Alejuarez10sk8/Router_CNC_12x_21y_21z/conexion_arduino_mega.png

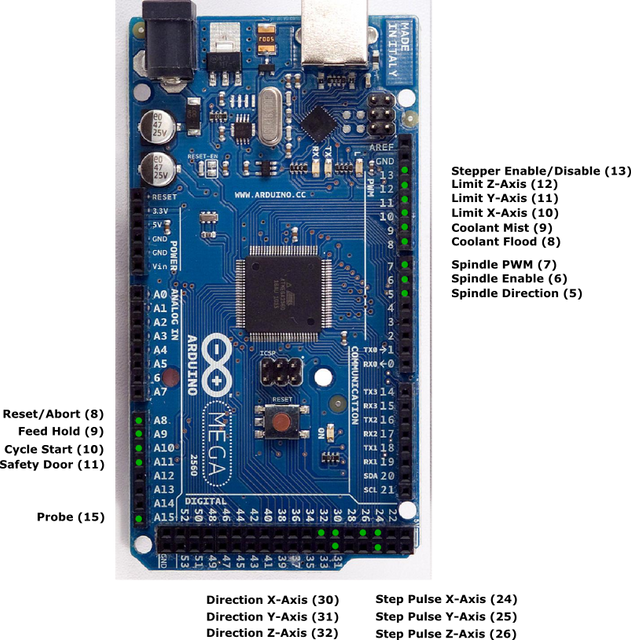
conexion_arduino_mega.png
