Alejuarez10sk8/Router_CNC_12x_21y_21z/README.md

# Router_CNC_12x_21y_21z
Primer_router_cnc
