Alejuarez10sk8/Router_CNC_12x_21y_21z/00_Componentes_presupuestos/COMPONENTES.xlsx

Nombre | Cantidad | Precio unitario ($) | Precio total ($) | Precio dólar | Fecha adquirida | Caracteristicas | Link
Motor Paso A Paso Nema 17 | 1 | 2834 | 2834 | 17.56 | 2021-09-27 | 42CM08-1A_0.8Nm | https://articulo.mercadolibre.com.ar/MLA-785472520-motor-paso-a-paso-nema-23-alto-torque-23-nm-2345-kgcm-_JM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
Motor Paso A Paso Nema 23 | 3 | 5057 | 15171 | 94.00 | 2021-09-27 | 57CM23-4A_24Vcc hasta 100Vcc_18Vca hasta 80Vca_2.3Nm | https://articulo.mercadolibre.com.ar/MLA-869936039-motor-paso-a-paso-nema-17-alto-torque-80-ncm-815-kgcm-_JM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
Perfil Aluminio Guía Lineal - 1 Metro | 4 | 1759 | 7036 | 43.59 | 2021-10-05 |  | https://articulo.mercadolibre.com.ar/MLA-856232254-perfil-aluminio-guia-lineal-1-metro-impresora-3d-cnc-_JM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
Rosca Cuadrada Acme De 5/8 X 1 Metro Con 2 Tuercas Redondas | 3 | 2800 | 8400 | 52.04 | 2021-10-05 |  | https://articulo.mercadolibre.com.ar/MLA-1103574786-rosca-cuadrada-acme-de-58-x-1-metro-con-2-tuercas-redondas-_JM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
Acero Sae 1045, Redondo Trefilado 16mm X 4 Mtrs - Cripton | 1 | 2768 | 3908 | 24.21 | 2021-10-05 | 16mm X 4 Mtrs los divido en 4 | https://articulo.mercadolibre.com.ar/MLA-852005307-acero-sae-1045-redondo-trefilado-16mm-x-4-mtrs-cripton-_JM
Fresadora Lüsqtoff FRL1400-9 1400W 220V | 1 | 13999 | 13999 | 86.73 | 2021-10-12 | Vel. mín 9000rpm Vel máx de 28000rpm Pesa 5.76kg. | https://www.mercadolibre.com.ar/fresadora-lusqtoff-frl1400-9-1400w-220v/p/MLA16062500
Driver Modular Tb6600 Step Paso A Paso 42v 4a | 4 | 2500 | 10000 | 61.96 | 2021-10-22 | Output current: IOUT = 5.0A (peak within 100ms) Rated output: IOUT = 4.5 A // Voltage: up to 40V | https://articulo.mercadolibre.com.ar/MLA-864924852-driver-modular-tb6600-step-paso-a-paso-42v-4a-arduino-ubot-_JM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
Arduino Mega | 2 | 1400 | 2800 | 16.97 | 2021-11-02 | Quemé uno | particular
Contacflux | 1 | 520 | 520 | 3.15 | 2021-11-09 |  | digital electronica
Bornera 2 Pines Paso 5mm | 10 |  | 287 | 1.74 | 2021-11-09 | 10 en 1 paquete | https://articulo.mercadolibre.com.ar/MLA-868322083-10-unidades-bornera-2-pines-paso-5mm-electronica-proyectos-_JM
Bornera 3 Pines Paso 5mm | 10 |  | 364 | 2.21 | 2021-11-09 | 10 en 1 paquete | https://articulo.mercadolibre.com.ar/MLA-868322046-10-unidades-bornera-3-pines-paso-5mm-electronica-proyectos-_JM
Plaqueta virgen 10*5cm pertinax | 1 | 90 | 90 | 0.55 | 2021-11-09 |  | digital electronica
Carro Rodamiento Lineal Abierto Sbr16 Sbr16uu // Ø 16mm | 8 | 1432.52 | 11460 | 69.45 | 2021-11-09 |  | https://articulo.mercadolibre.com.ar/MLA-607166347-carro-rodamiento-lineal-abierto-sbr16-sbr16uu-16mm-_JM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
Rodamiento Lineal Cerrado Scs12uu // Ø 12mm | 4 | 953.3 | 3813 | 23.11 | 2021-11-09 |  | https://articulo.mercadolibre.com.ar/MLA-809228968-rodamiento-lineal-cerrado-scs12uu-12mm-_JM?quantity=4
Barra Eje Lineal 12mm Hrc60 Templada Rectificada Cromada | 1 | 2101 | 2101 | 12.73 | 2021-11-09 | 500mm cortada en dos (250mm=25cm cada una) | https://articulo.mercadolibre.com.ar/MLA-761514484-barra-eje-lineal-12mm-hrc60-templada-rectificada-cromada-_JM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
Micro Switch Final De Carrera | 4 | 100 | 400 | 2.42 | 2021-11-09 | 5A 250v Cnc Arduino Leva Corta | particular
Fuente Switching Biqu (24v / 360w / 15A ) | 2 | 5605 | 12010 | 71.49 | 2021-12-03 | 215x114x50mm (Biqu-B1 / Ender-3) | https://proyectocolor.com.ar/productos/fuente-switching-biqu-24v-360w-15a-215x114x50mm-biqu-b1-ender-3/
Caño rectangular 20x40x2MM 1mt | 8 | 587.5 | 4700 | 27.98 | 2021-12-13 | 1mt | gudiño
Angulo 38.1 x 3.2mm 6.60mts | 1 | 3000 | 3000 | 17.86 | 2021-12-13 | 4 x 70 - 2 x 90 - 2 x 100 | gudiño
Cable mallado 4x1mm 8mts | 1 | 2694 | 2200 | 13.10 | 2021-12-13 | 8mts/ descuento | electrosur
Ruleman skf 99502H | 2 | 300 | 600 | 3.57 | 2021-12-13 | 5/8 interior | parussa rodamientos
Planchuela eje y | 2 | 1600 | 3200 | 19.05 | 2021-12-28 | 4.5kg (2.25 c/u) | gudiño
Planchuela de agarre | 4 | 650 | 2600 | 15.48 | 2021-12-28 | 2.6kg(650g c/u) | gudiño
Angulo 25.4x3.2mm x 0.85mt | 1 | 300 | 300 | 1.79 | 2021-12-28 |  | gudiño
Planchuela 50x3.2mmx 0.25mt | 1 | 150 | 150 | 0.89 | 2021-12-28 | 4x51mm | gudiño
Pintar planchuelas y estructura | 1 | 3800 | 3800 | 21.73 | 2022-01-11 |  | color extremo
Bulones y arandelas | 1 |  | 2000 | 11.44 | 2022-01-25 | bulones 5mm y 5.5mm - tornillos para plaquetas 3mm - tornillos 2mm | Bulonera Centro
Cables para driver y fuente s | 1 |  | 1000 | 5.72 | 2022-02-04 | 2 metros de cable rojo y negro 0.75/1mm2 - 0.5 metros de cable marron y azul 1.5mm2 - 2 metros de cable verde con linea amarrillas 1.5 mm2 | electrosur
Fibro facil | 5 | 120 | 600 | 3.43 | 2022-01-11 | 350x550x2 + 350x150x2 + 550x150x2 mm | Nobs. NO COMPRAR MÁS AHÍ
Cable UTP categoria 6 o superior | 1 | 200 | 200 | 1.14 | 2022-01-18 | 2 metros | Memory
Impresiones 3d | 1 | 1000 | 1000 | 5.72 | 2022-02-14 | Placa para sostener arduino- bulones para travar varillas | particular
Cable de alimentación 220v con descarga a tierra | 1 | 400 | 400 | 2.29 | 2022-02-14 | 1.5mm diametro | digital electronica
Llave Tecla 3 Contacto Con Luz On-off 15a 250v Rojo | 2 | 350 | 700 | 4.00 | 2022-02-14 | Llave Tecla Redonda Interruptora S-luz 220v - rompí uno - Encontré de tres contacto | electrosur
Bisagra Libro 5005 Bronceada 51mm | 2 | 100 | 200 | 1.14 | 2022-02-14 |  | ferreteria
Interruptor palanca bipolar | 1 | 645 | 645 | 3.69 | 2022-03-01 | 15A | electrosur
Ficha machos con tierra | 2 | 215 | 430 | 2.46 | 2022-03-01 | 20A | electrosur
Tapa blanca de luz | 5 | 44 | 220 | 1.26 | 2022-03-01 |  | electrosur
base de luz blanco | 5 | 35 | 175 | 1.00 | 2022-03-01 |  | electrosur
toma bipolar + tierra | 5 | 170 | 850 | 4.86 | 2022-03-01 | 20A | electrosur
cable 3x1 1,5mm2 | 1 | 173 | 346 | 1.98 | 2022-03-01 | 2,5m | electrosur
cable 3x1 2,5mm2 | 1 | 271 | 815 | 4.66 | 2022-03-01 | 3m | electrosur
Planchuela de acero para agarre de eje Z | 1 | 2500 | 2500 | 13.23 | 2022-05-01 |  | Nico Aimar
Plachuela de acero C de eje Z | 1 | 2000 | 2000 | 10.58 | 2022-05-07 |  | Nico Aimar
 |  |  | 129824 | 783.94
