Alejuarez10sk8/Router_CNC_12x_21y_21z/0_Estructura cnc/Router_CNC_12x_21y_21z.SLDASM

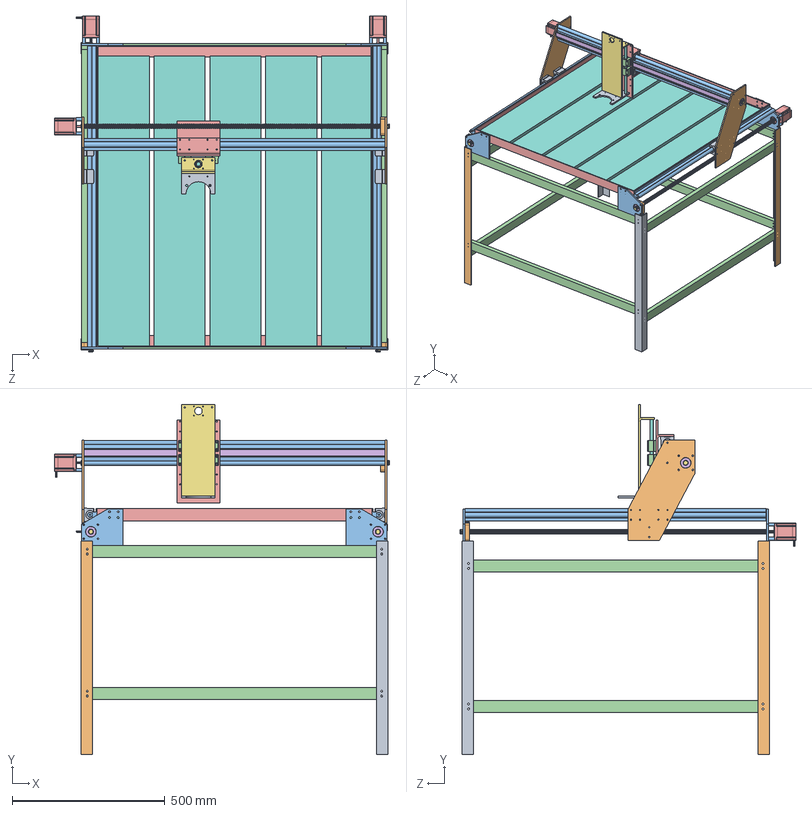
[picture p2: CAD file, 2022-06-06]
0_Estructura cnc/Router_CNC_12x_21y_21z.SLDASM
1096.7 x 1147.3 x 1100.0 mm
Perfil_L_3x38x700 x 2
Simetría_Perfil_L_3x38x700 x 2
Planchuela_eje_X x 4
caño_2x40x20x1000 x 8
estructura_mesa_900x1000
Ruleman16 x 3
rosca_acme_16 x 3
planchas_de_madera
SBR16UU Single Linear Bearing x 8
Planchuela_eje_Y x 2
varilla16_con_soporte_de_aluminio x 4
SCS12UU x 4
planchuela_plegada_en_C_eje_Z
caño_2x40x20x985
planchuela_plegada_parte_de_arriba_Z
varilla_12 x 2
planchuela_parte_de_abajo_Z
apoya_ruleman_int16mm_ext35mm x 3
Separador_motores_20mm x 12
apoya_ruleman_int8mm_ext22mm
NEMA 23.step x 3
