Alejuarez10sk8/Router_CNC_12x_21y_21z/0_Estructura cnc/planchas_de_madera.SLDPRT

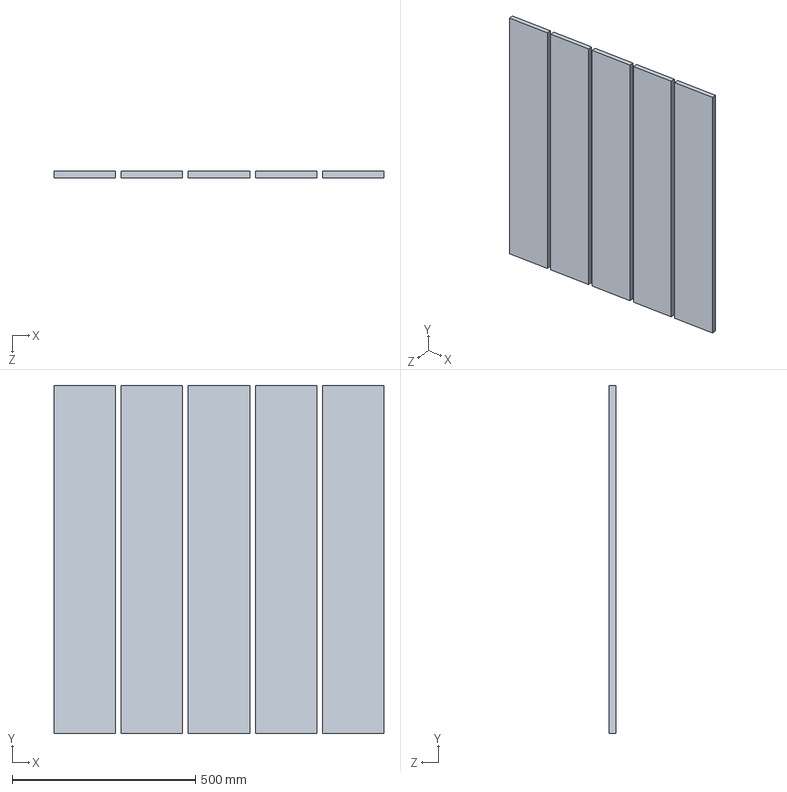
[picture p3: CAD file, 2022-06-06]
0_Estructura cnc/planchas_de_madera.SLDPRT
900.0 x 950.0 x 18.0 mm
