Alejuarez10sk8/Router_CNC_12x_21y_21z/0_Estructura cnc/Ruleman16.SLDPRT

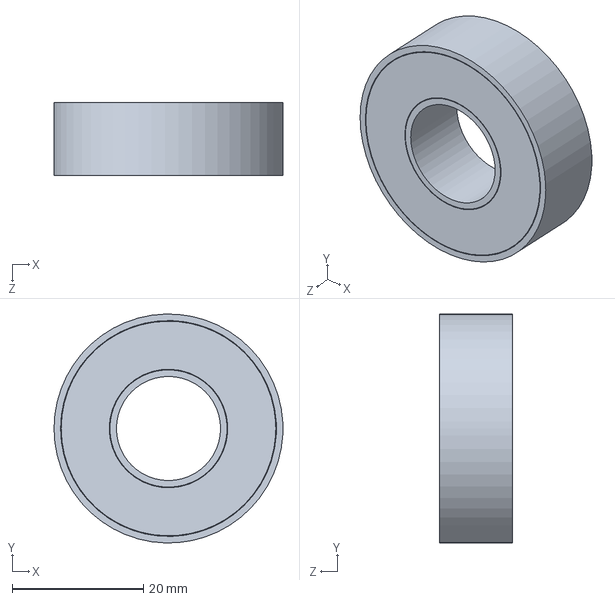
[picture p4: CAD file, 2022-06-06]
0_Estructura cnc/Ruleman16.SLDPRT
34.9 x 34.9 x 11.1 mm
