Alejuarez10sk8/Router_CNC_12x_21y_21z/0_Estructura cnc/apoya_ruleman_int8mm_ext22mm.SLDPRT

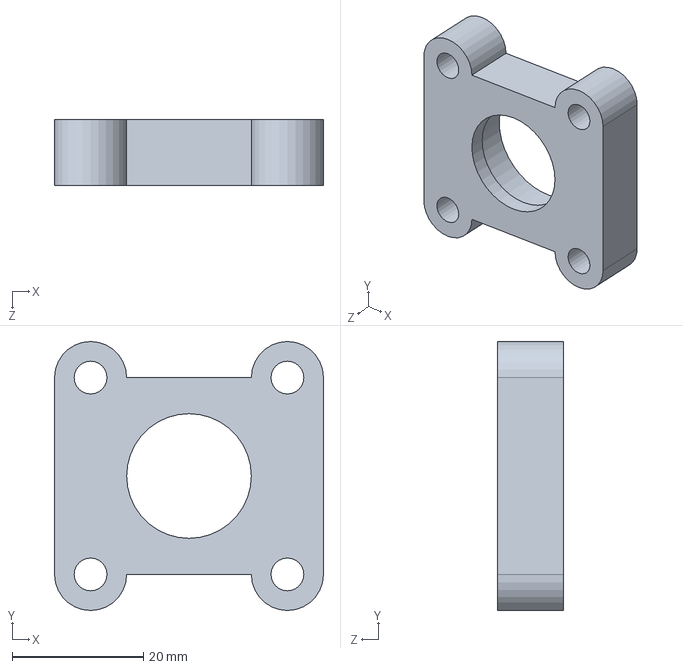
[picture p5: CAD file, 2022-06-06]
0_Estructura cnc/apoya_ruleman_int8mm_ext22mm.SLDPRT
41.0 x 41.0 x 10.0 mm
