Alejuarez10sk8/Router_CNC_12x_21y_21z/0_Estructura cnc/rosca_acme_16.SLDPRT

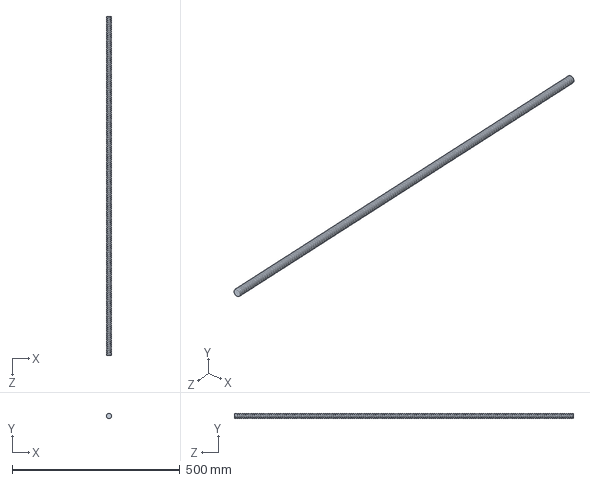
[picture p6: CAD file, 2022-06-06]
0_Estructura cnc/rosca_acme_16.SLDPRT
15.9 x 15.9 x 1010.0 mm
