Alejuarez10sk8/Router_CNC_12x_21y_21z/0_Estructura cnc/NEMA 23.STEP

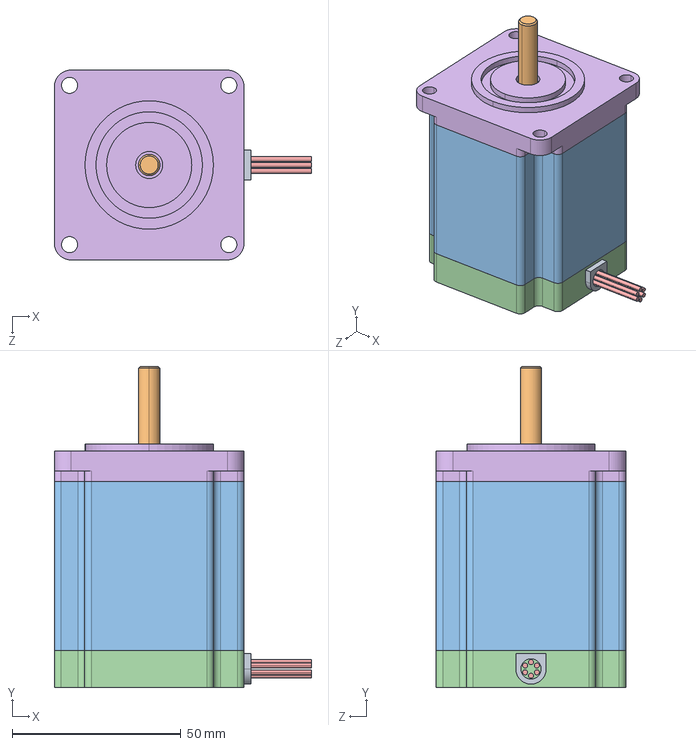
[picture p7: CAD file, 2022-06-06]
0_Estructura cnc/NEMA 23.STEP
76.2 x 95.0 x 56.2 mm
