Alejuarez10sk8/Router_CNC_12x_21y_21z/0_Estructura cnc/planchuela_parte_de_abajo_Z.SLDPRT

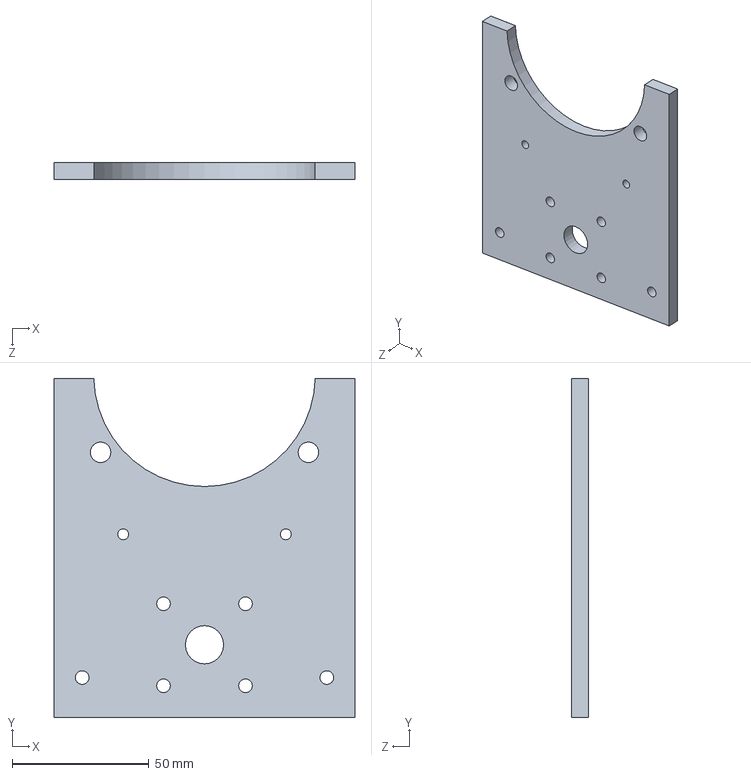
[picture p8: CAD file, 2022-06-06]
0_Estructura cnc/planchuela_parte_de_abajo_Z.SLDPRT
110.0 x 124.0 x 6.35 mm
