Alejuarez10sk8/Router_CNC_12x_21y_21z/0_Estructura cnc/varilla16_con_soporte_de_aluminio.SLDPRT

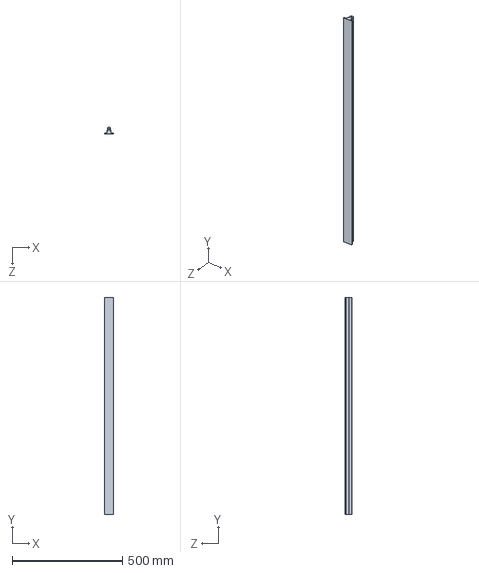
[picture p10: CAD file, 2022-06-06]
0_Estructura cnc/varilla16_con_soporte_de_aluminio.SLDPRT
40.0 x 985.0 x 31.0 mm
