Alejuarez10sk8/Router_CNC_12x_21y_21z/0_Estructura cnc/Separador_motores_10mm.SLDPRT

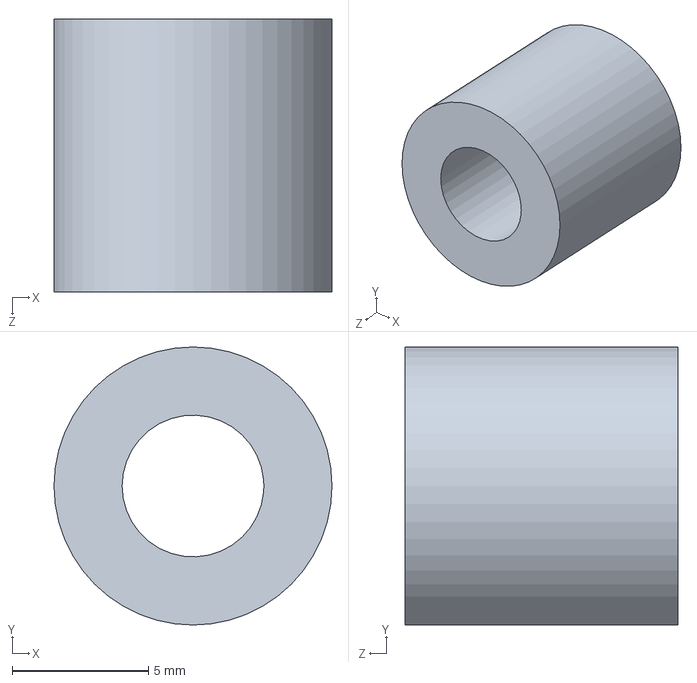
[picture p11: CAD file, 2022-06-06]
0_Estructura cnc/Separador_motores_10mm.SLDPRT
10.2 x 10.2 x 10.0 mm
