Alejuarez10sk8/Router_CNC_12x_21y_21z/0_Estructura cnc/Perfil_L_3x38x700.SLDPRT

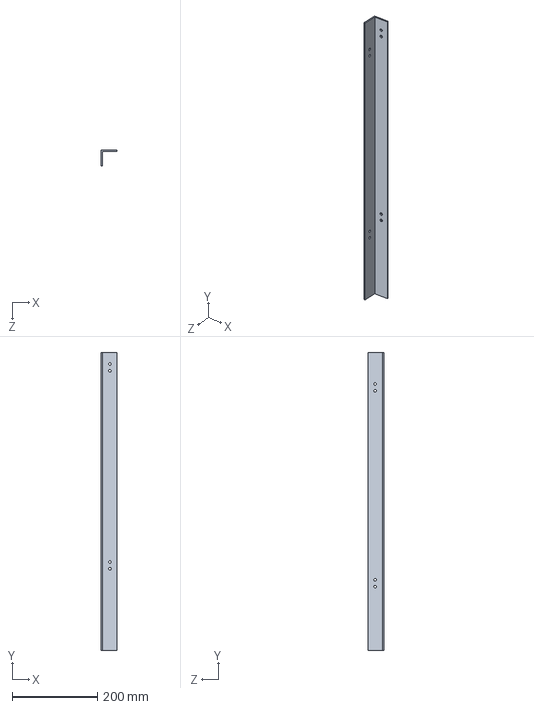
[picture p12: CAD file, 2022-06-06]
0_Estructura cnc/Perfil_L_3x38x700.SLDPRT
38.1 x 700.0 x 38.1 mm
