Alejuarez10sk8/Router_CNC_12x_21y_21z/0_Estructura cnc/Tuerca_de_bloqueo_rosca_acme_16.SLDPRT

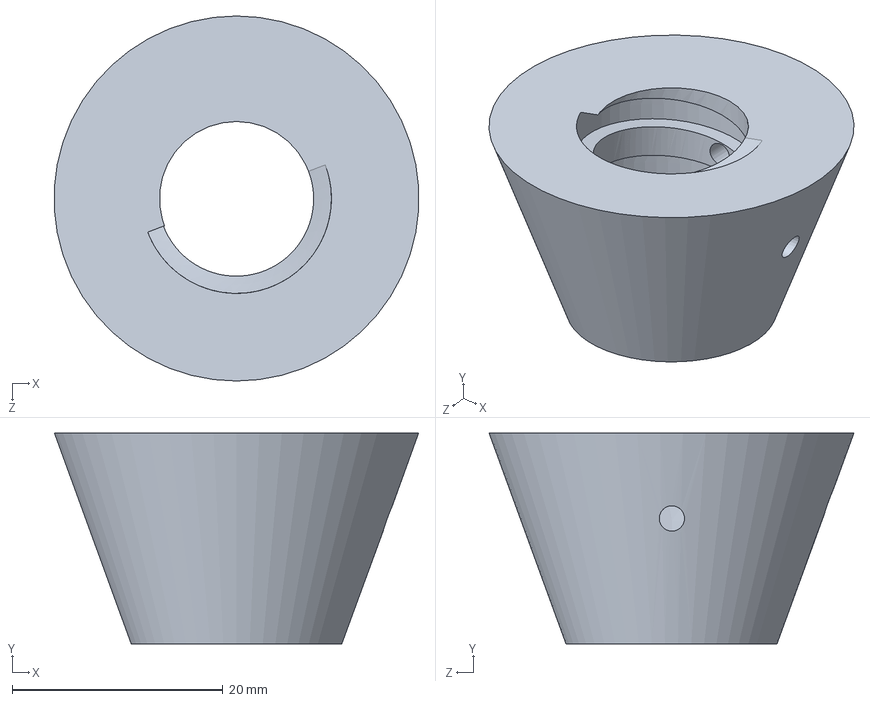
[picture p13: CAD file, 2022-06-06]
0_Estructura cnc/Tuerca_de_bloqueo_rosca_acme_16.SLDPRT
34.5 x 20.0 x 34.6 mm
