Alejuarez10sk8/Router_CNC_12x_21y_21z/0_Estructura cnc/caño_2x40x20x985.SLDPRT

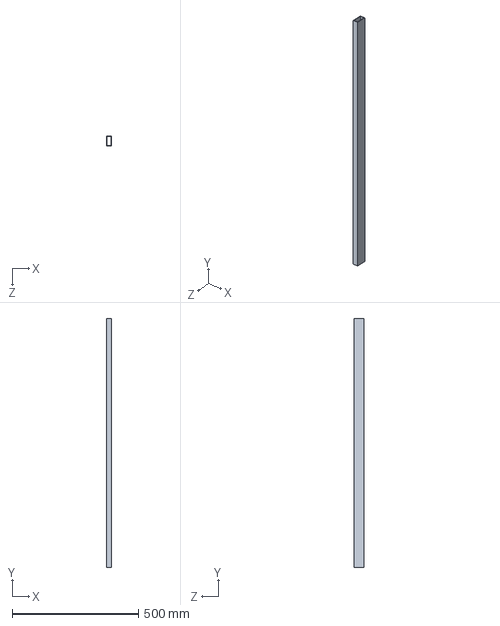
[picture p15: CAD file, 2022-06-06]
0_Estructura cnc/caño_2x40x20x985.SLDPRT
20.0 x 985.5 x 40.0 mm
