Alejuarez10sk8/Router_CNC_12x_21y_21z/0_Estructura cnc/planchuela_plegada_en_C_eje_Z.SLDPRT

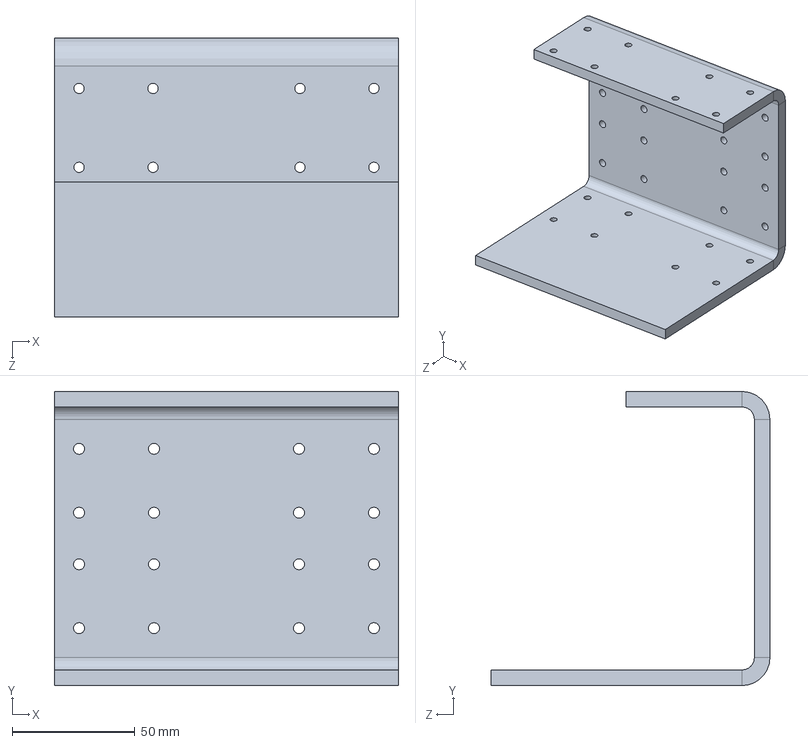
[picture p16: CAD file, 2022-06-06]
0_Estructura cnc/planchuela_plegada_en_C_eje_Z.SLDPRT
140.0 x 119.7 x 113.5 mm
