Alejuarez10sk8/Router_CNC_12x_21y_21z/0_Estructura cnc/SBR16UU Single Linear Bearing.SLDPRT

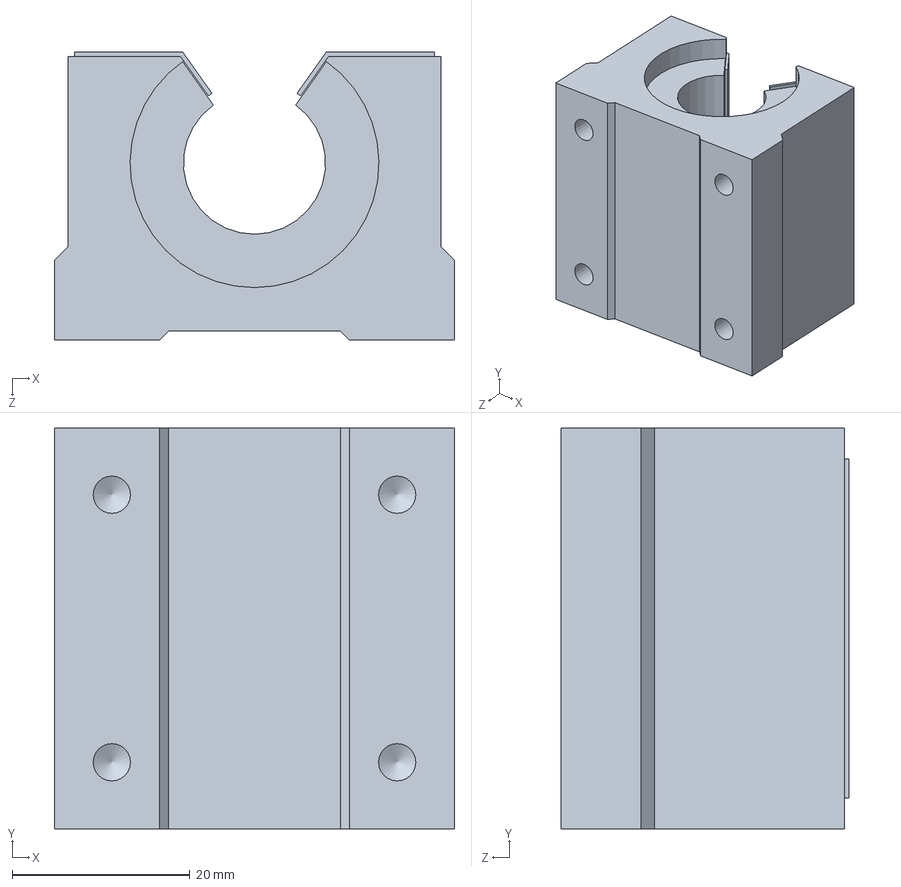
[picture p17: CAD file, 2022-06-06]
0_Estructura cnc/SBR16UU Single Linear Bearing.SLDPRT
45.0 x 45.1 x 32.4 mm
