Alejuarez10sk8/Router_CNC_12x_21y_21z/0_Estructura cnc/apoya_ruleman_int16mm_ext35mm.SLDPRT

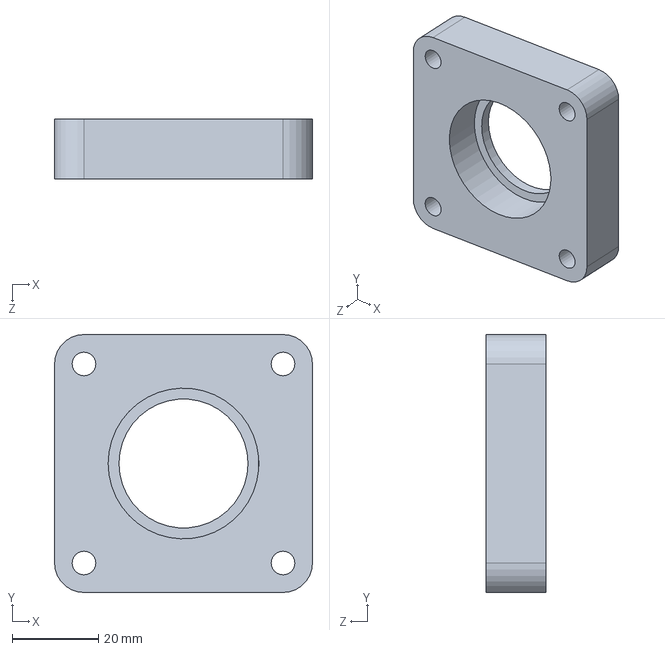
[picture p18: CAD file, 2022-06-06]
0_Estructura cnc/apoya_ruleman_int16mm_ext35mm.SLDPRT
60.0 x 60.0 x 14.1 mm
