Alejuarez10sk8/Router_CNC_12x_21y_21z/0_Estructura cnc/Planchuela_eje_X.SLDPRT

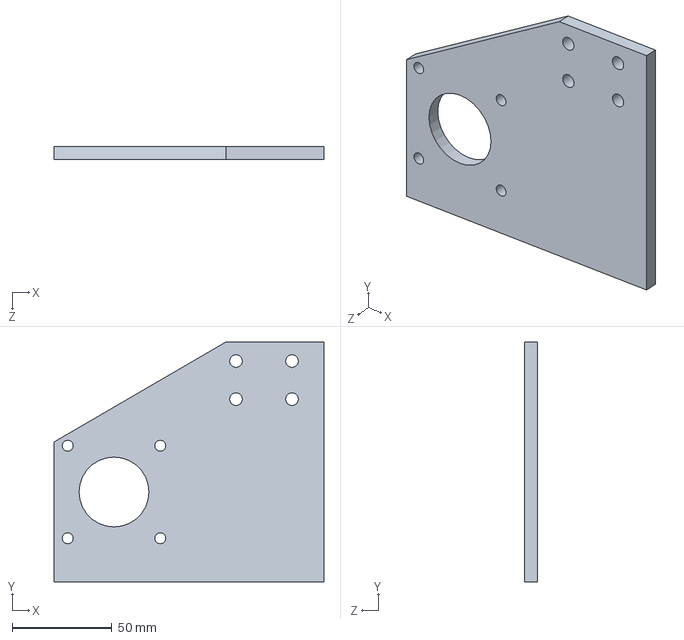
[picture p19: CAD file, 2022-06-06]
0_Estructura cnc/Planchuela_eje_X.SLDPRT
135.0 x 120.0 x 6.35 mm
