Alejuarez10sk8/Router_CNC_12x_21y_21z/0_Estructura cnc/SCS12UU.SLDPRT

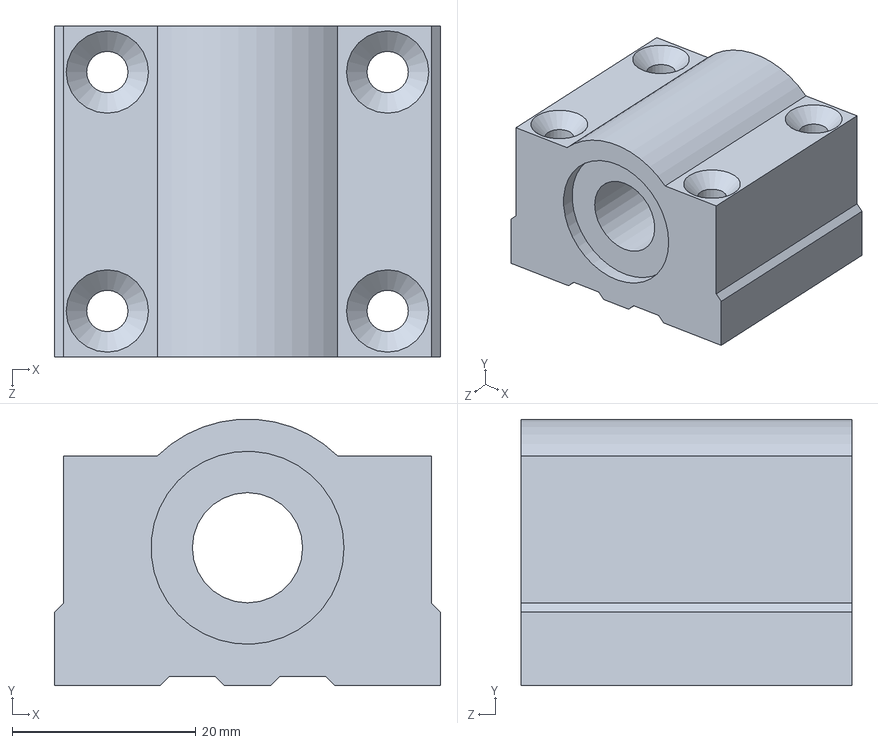
[picture p20: CAD file, 2022-06-06]
0_Estructura cnc/SCS12UU.SLDPRT
42.0 x 29.0 x 36.0 mm
