Alejuarez10sk8/Router_CNC_12x_21y_21z/0_Estructura cnc/Planchuela_eje_Y.SLDPRT

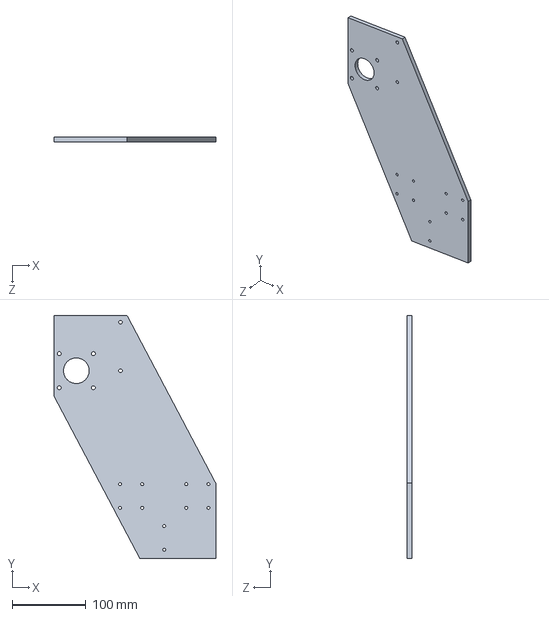
[picture p21: CAD file, 2022-06-06]
0_Estructura cnc/Planchuela_eje_Y.SLDPRT
219.4 x 330.0 x 6.35 mm
