Alejuarez10sk8/Router_CNC_12x_21y_21z/0_Estructura cnc/planchuela_plegada_parte_de_arriba_Z.SLDPRT

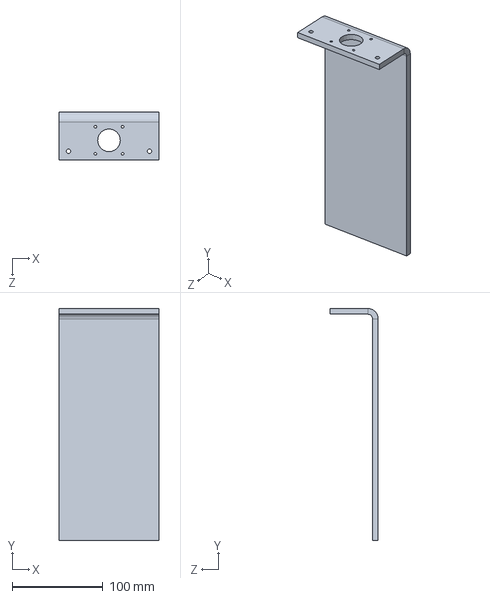
[picture p22: CAD file, 2022-06-06]
0_Estructura cnc/planchuela_plegada_parte_de_arriba_Z.SLDPRT
110.0 x 256.4 x 53.5 mm
