Alejuarez10sk8/Router_CNC_12x_21y_21z/0_Estructura cnc/varilla_12.SLDPRT

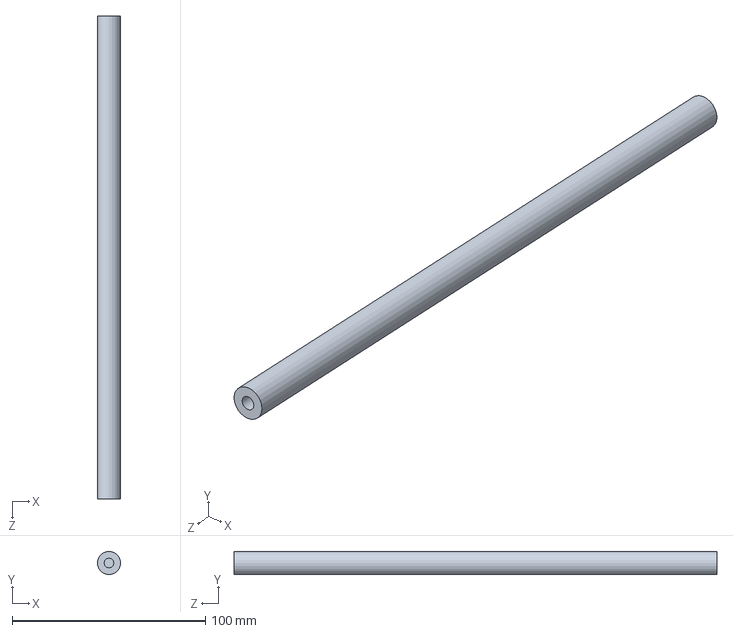
[picture p23: CAD file, 2022-06-06]
0_Estructura cnc/varilla_12.SLDPRT
12.0 x 12.0 x 250.0 mm
