Alejuarez10sk8/Router_CNC_12x_21y_21z/0_Estructura cnc/caño_2x40x20x1000.SLDPRT

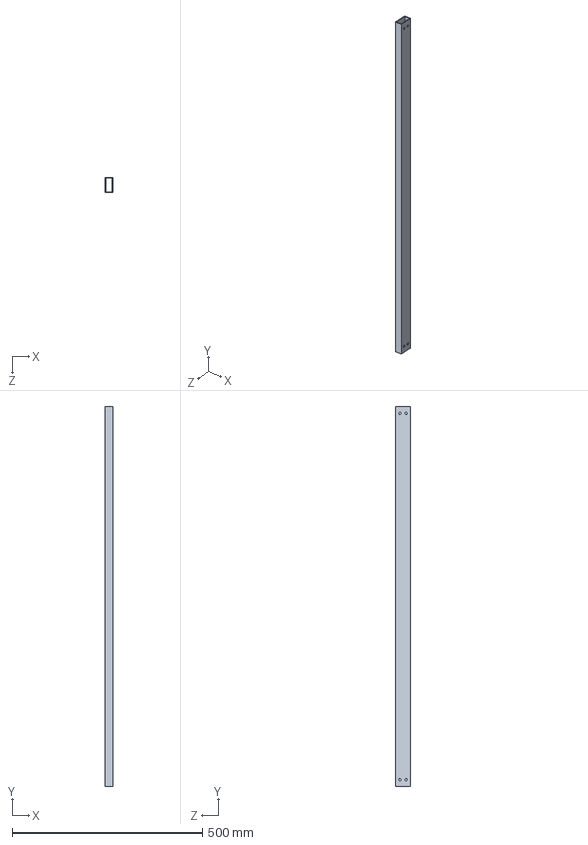
[picture p24: CAD file, 2022-06-06]
0_Estructura cnc/caño_2x40x20x1000.SLDPRT
20.0 x 1000.0 x 40.0 mm
