Alejuarez10sk8/Router_CNC_12x_21y_21z/0_Estructura cnc/estructura_mesa_900x1000.SLDPRT

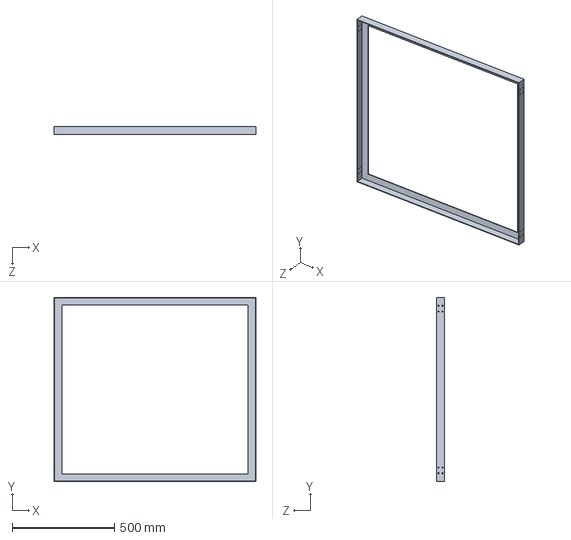
[picture p25: CAD file, 2022-06-06]
0_Estructura cnc/estructura_mesa_900x1000.SLDPRT
987.3 x 900.0 x 41.2 mm
