Alejuarez10sk8/Router_CNC_12x_21y_21z/(list of files, cad)

Other CAD files:
0_Estructura cnc/Simetría_Perfil_L_3x38x700.SLDPRT
