Alejuarez10sk8/Router_CNC_12x_21y_21z/1_Pcb_electronica/cnc control/cnc control.kicad_pcb

## KiCad design 1_Pcb_electronica/cnc control/cnc control.kicad_pcb (2022-06-06)

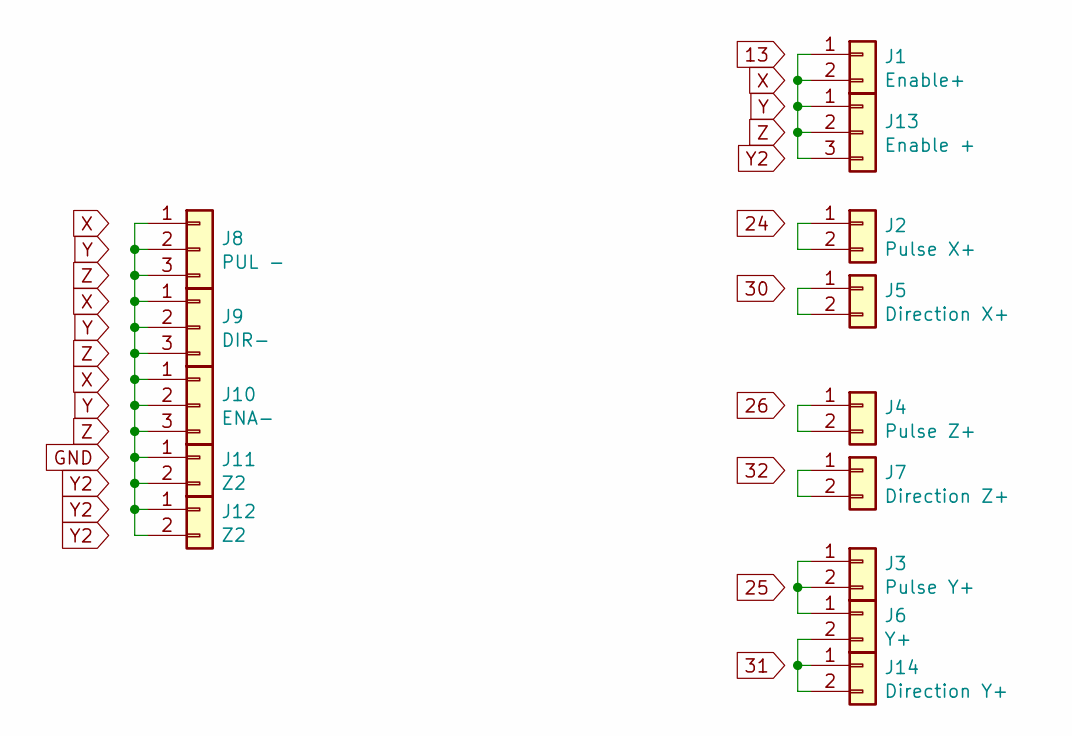
[picture p26: schematic cnc control.sch]

Parts:
J1: Enable+; TerminalBlock_bornier-2_P5.08mm
J2: Pulse X+; TerminalBlock_bornier-2_P5.08mm
J3: Pulse Y+; TerminalBlock_bornier-2_P5.08mm
J4: Pulse Z+; TerminalBlock_bornier-2_P5.08mm
J5: Direction X+; TerminalBlock_bornier-2_P5.08mm
J6: Y+; TerminalBlock_bornier-2_P5.08mm
J7: Direction Z+; TerminalBlock_bornier-2_P5.08mm
J8: PUL -; TerminalBlock_bornier-3_P5.08mm
J9: DIR-; TerminalBlock_bornier-3_P5.08mm
J10: ENA-; TerminalBlock_bornier-3_P5.08mm
J11, J12: Z2; TerminalBlock_bornier-2_P5.08mm
J13: Enable +; TerminalBlock_bornier-3_P5.08mm
J14: Direction Y+; TerminalBlock_bornier-2_P5.08mm

Connections:
unnamed: J1.1, J1.2, J13.1, J13.2, J13.3
unnamed: J2.1, J2.2
unnamed: J3.1, J3.2, J6.1
unnamed: J4.1, J4.2
unnamed: J5.1, J5.2
unnamed: J7.1, J7.2
unnamed: J8.1, J8.2, J8.3, J9.1, J9.2, J9.3, J10.1, J10.2, J10.3, J11.1, J11.2, J12.1, J12.2
unnamed: J6.2, J14.1, J14.2

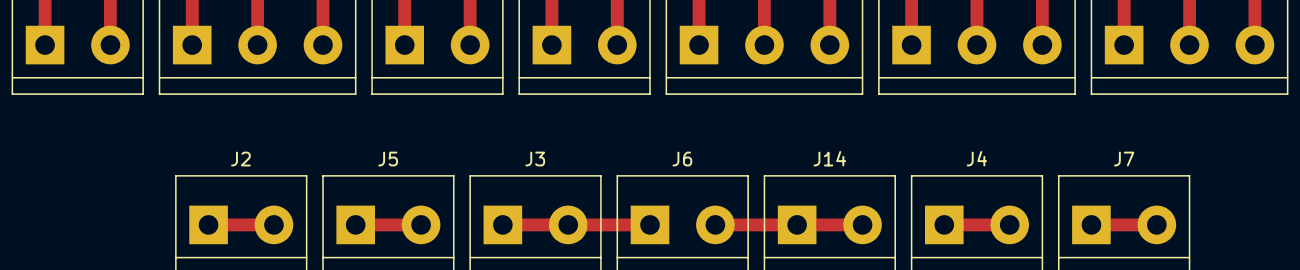
[picture p27: board cnc control.kicad_pcb from above]

Board: 2 copper layers, 14 parts (0 on the bottom side), 8 nets.
