Alejuarez10sk8/Router_CNC_12x_21y_21z/1_Pcb_electronica/cnc Potencia/cnc Potencia.kicad_pcb

## KiCad design 1_Pcb_electronica/cnc Potencia/cnc Potencia.kicad_pcb (2022-06-06)

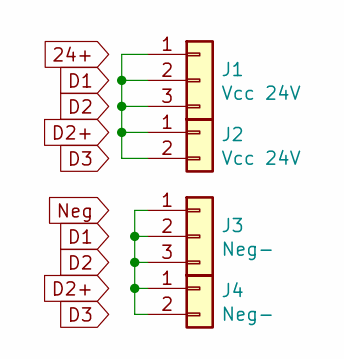
[picture p28: schematic cnc Potencia.sch]

Parts:
J1: Vcc 24V; TerminalBlock_bornier-3_P5.08mm
J2: Vcc 24V; TerminalBlock_bornier-2_P5.08mm
J3: Neg-; TerminalBlock_bornier-3_P5.08mm
J4: Neg-; TerminalBlock_bornier-2_P5.08mm

Connections:
unnamed: J1.1, J1.2, J1.3, J2.1, J2.2
unnamed: J3.1, J3.2, J3.3, J4.1, J4.2

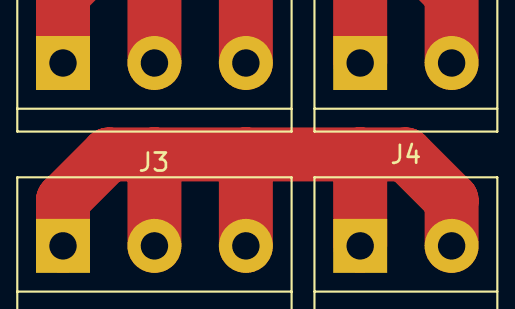
[picture p29: board cnc Potencia.kicad_pcb from above]

Board: 2 copper layers, 4 parts (0 on the bottom side), 2 nets.
